sternj/sternmidi/README.md

# MIDI interfaces and controllers

#### Contents
1. Projects
    * Contains code and other documentation, divided by the week in the semester it was written
    
2. Lab Notebook
    * Contains a summary of work done each week, goals for the next week, and confounding factors which may impede said work.
