sternj/sternmidi/docs/photos.md

# Photos of constructed MIDI controllers

## Static controller

Front plate

aaaaaaaaaaaaaaaaaaaa

Front plate first version

Back plate

Back plate in progress


## Responsive controller
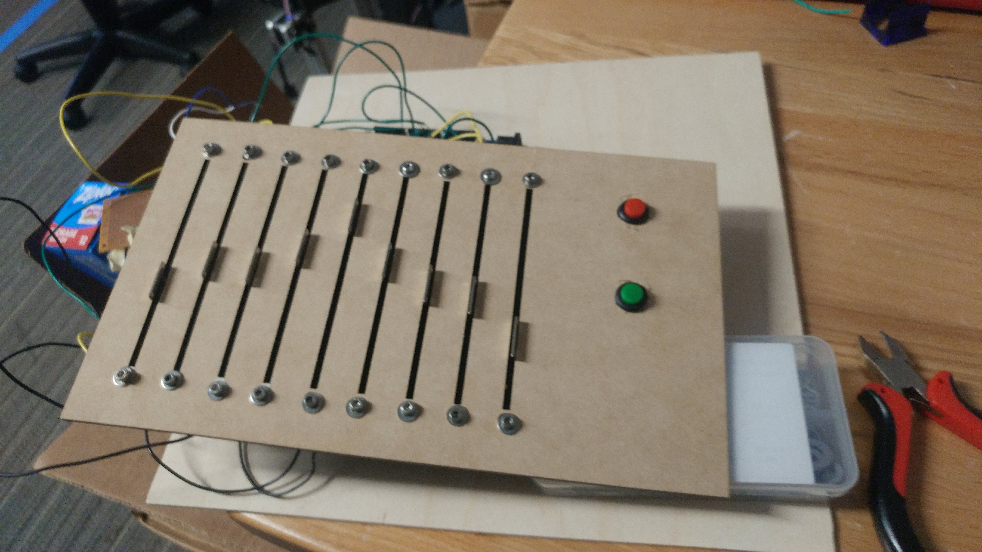
[picture p6: docs/Photos/20171210_162646.jpg]
Controller

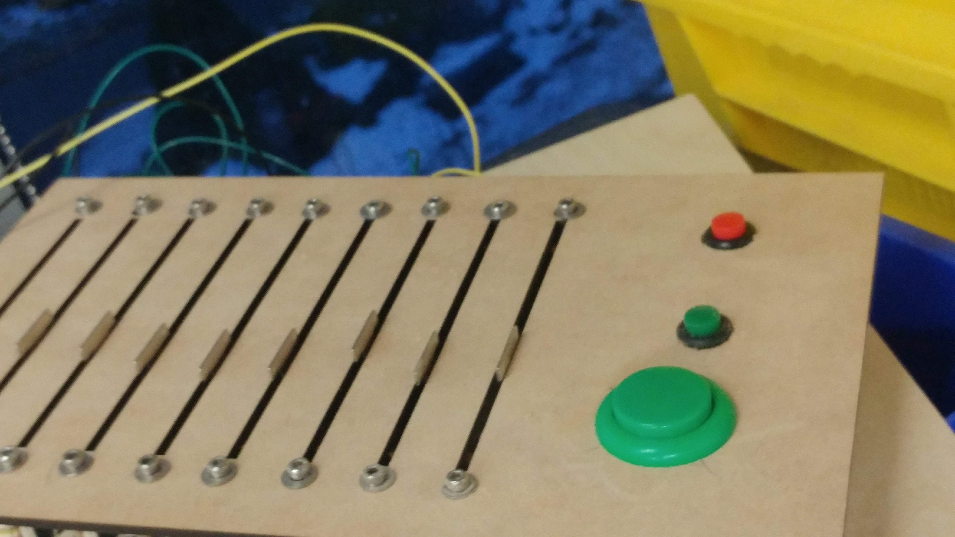
[picture p7: docs/Photos/20171212_161137.jpg]
Other view

Solder joints
