sternj/sternmidi/Lab Notebook/Week3.md

# Completed this week
- Potentiometers (2) obtained
- Completed training to access MakerLab
- Prototyped a functioning MIDI controller containing two buttons and two potentiometers. Tested on OSX using Logic Pro X and Tassman

# Goals for next week
- Reach out to Roli for information on student pricing
- Design and implement a case for an 8-knob MIDI controller
- Figure out how to mount Arduino Due as USB-MIDI device
- Set up Trello workspace
- Begin keeping careful notes in this notebook
# Mitigating factors
- None, I just need to buy a few potentiometers.
