sternj/sternmidi/Lab Notebook/Week2.md

# Completed this week
- Obtained Arduino Due
- Completed research on MIDI standards, control signals
- Presented research on MIDI standards, control signals
# Not completed this week
- Integrate potentiometer with MIDI framework
# Goals for next week
- Obtain potentiometer
- Figure out how to use analog inputs on Arduino Uno
- Make MIDI controller with at least 1 button and at least 1 potentiometer
# Barriers
- Lack of potentiometer
