sternj/sternmidi/Lab Notebook/Week7/10-25-17.md

# Completed this week
- rewired the faceplate again, reducing its messiness further
- Completed setup for JUCE library
- Finished the first write of the Arduino firmware

# Goals for next week
- Rewire the faceplate to make it neater and more intutive
- Finish testing on all buttons
- Rewire buttons to reflect natural ordering and permit debugging
- rewrite program to allow for visual debugging

# Deliverables for next week
- The completed faceplate, fully functioning, neat, and with software.
