sternj/sternmidi/docs/Photos/20171212_154258.jpg

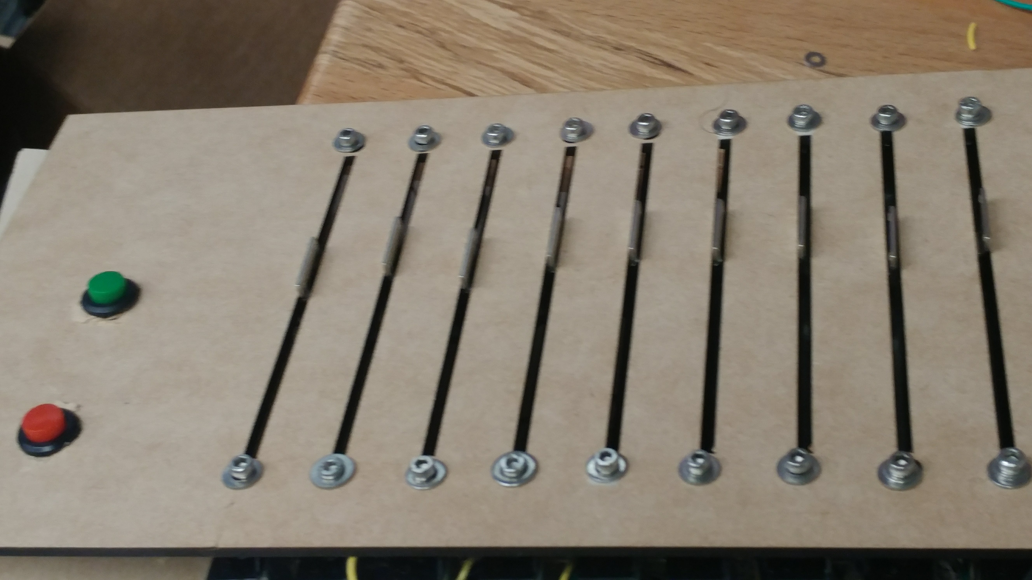
docs/Photos/20171212_154258.jpg
