sternj/sternmidi/(commit log)

2017-11-17 Arduino projects
2017-12-01 Migrated Arduino files to git
