sternj/sternmidi/Photos/20171212_154232.jpg

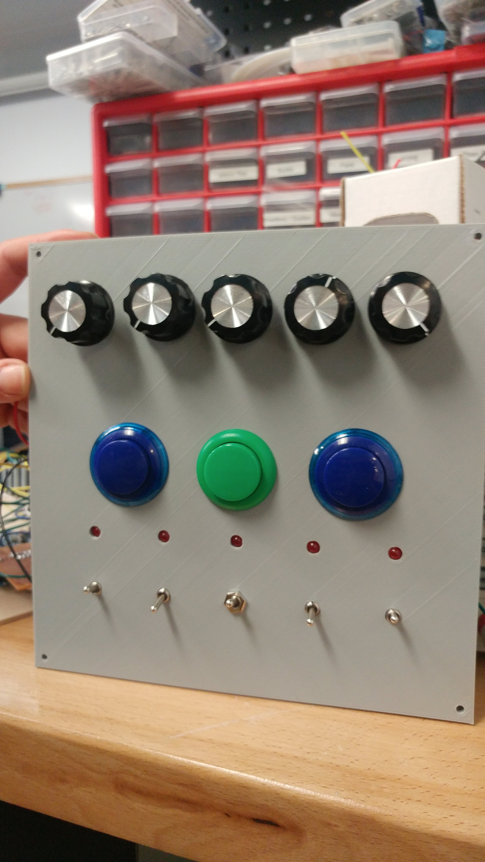
[picture p1: docs/Photos/20171212_154232.jpg]
Photos/20171212_154232.jpg
