sternj/sternmidi/Lab Notebook/week6/20171010_171403.jpg

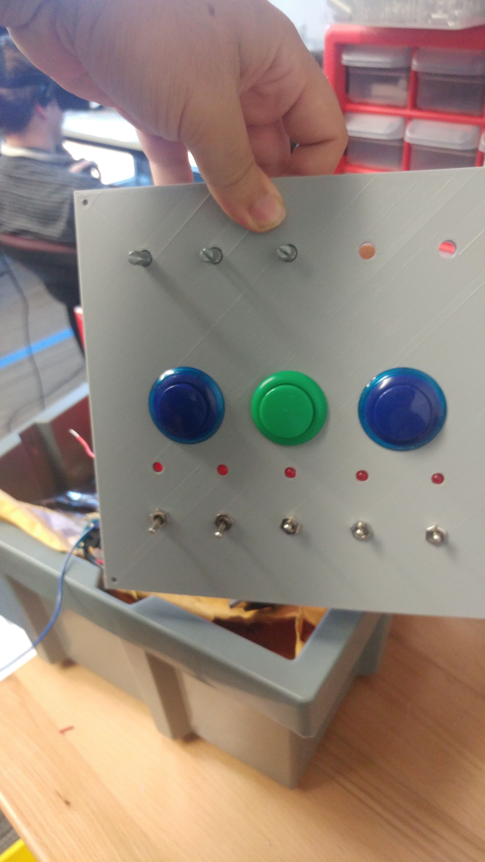
[picture p2: docs/Photos/20171010_171403.jpg]
Lab Notebook/week6/20171010_171403.jpg
