sternj/sternmidi/Lab Notebook/week6/20171011_205814.jpg

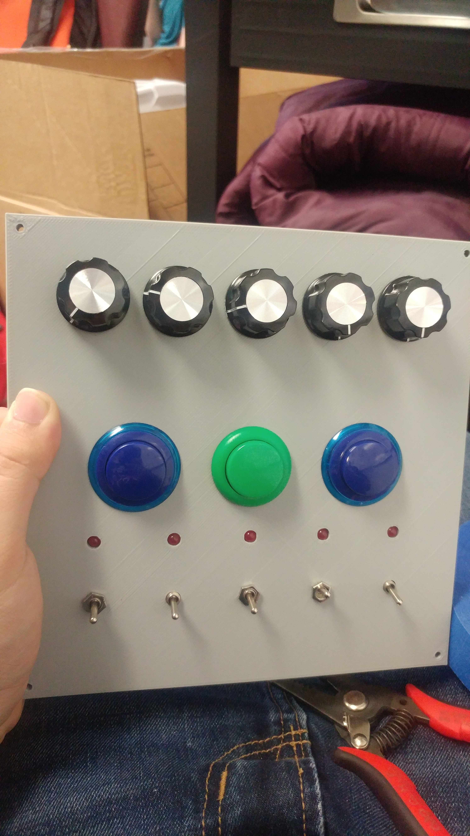
[picture p3: docs/Photos/20171011_205814.jpg]
Lab Notebook/week6/20171011_205814.jpg
