sternj/sternmidi/Photos/20171212_154315.jpg

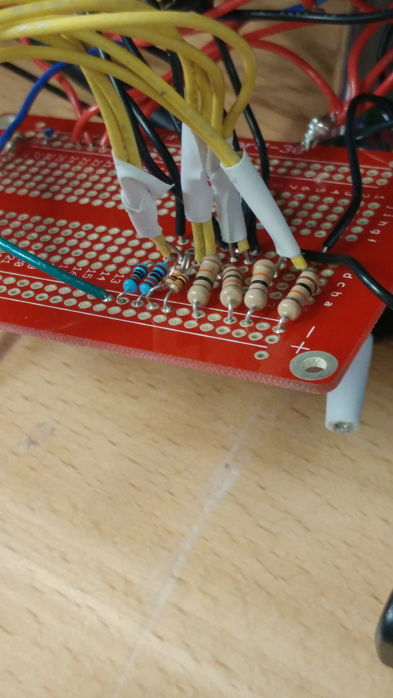
[picture p4: docs/Photos/20171212_154315.jpg]
Photos/20171212_154315.jpg
