sternj/sternmidi/Lab Notebook/week6/20171010_165239.jpg

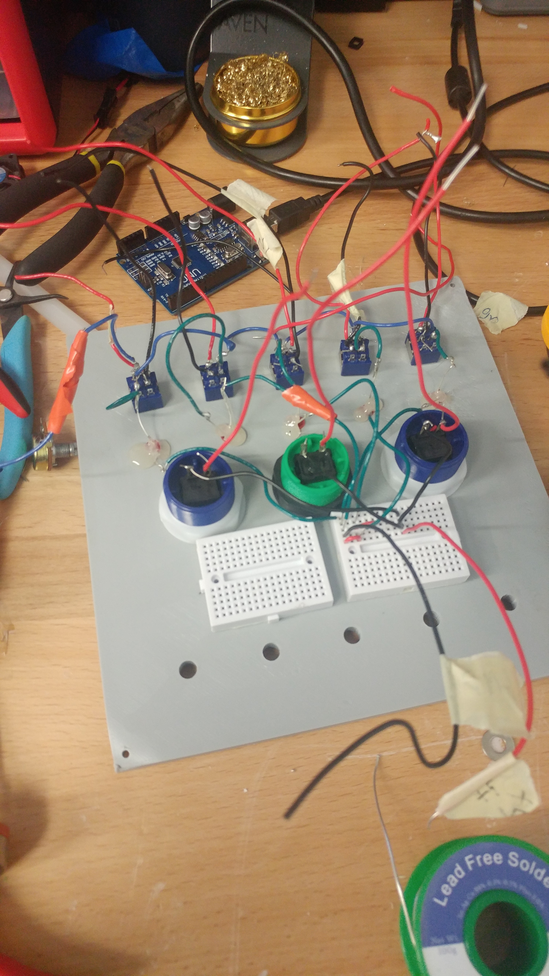
[picture p5: docs/Photos/20171010_165239.jpg]
Lab Notebook/week6/20171010_165239.jpg
