sternj/sternmidi/Photos/20171212_154252.jpg

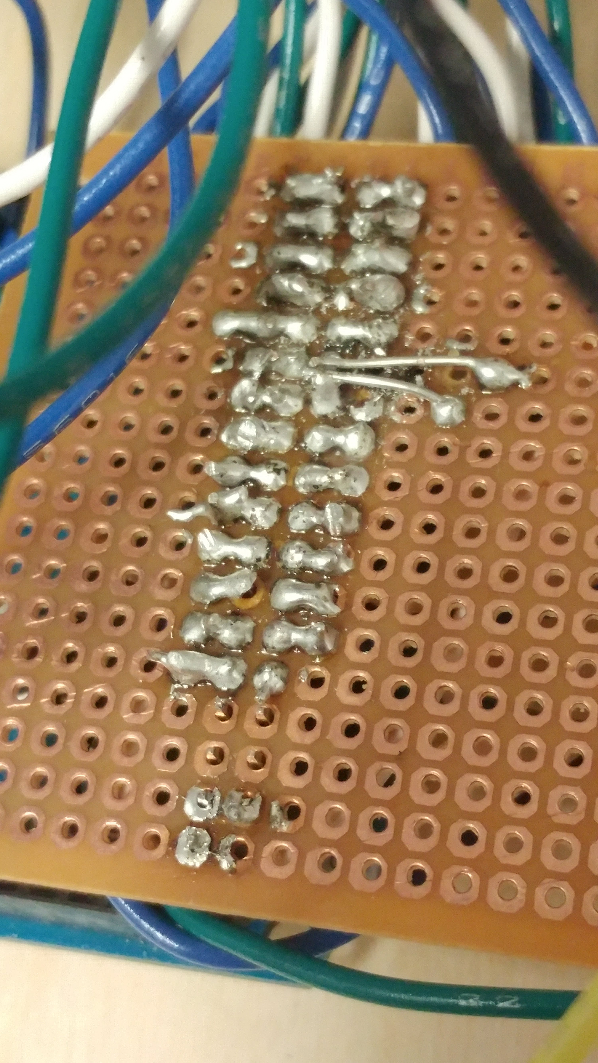
[picture p8: docs/Photos/20171212_154252.jpg]
Photos/20171212_154252.jpg
